Natalie-Leaist/I2C-Level-Converter/I2C-level-Converter/BR-100060-002_RevB_PCBA_Outputs/I2C-level-Converter Odoo BOM.xlsx

External ID | Reference | Product | Quantity | BoM Type | BoM Lines/Component | BoM Lines/Quantity
mrp_bom_BR-100060-002 | BOM_PCB | BR-100060-002 | 1 | Manufacture this product | component.bre_BRE_000034 | 2
mrp_bom_BR-100060-002 | BOM_PCB | BR-100060-002 | 1 | Manufacture this product | component.bre_BRE_000038 | 2
mrp_bom_BR-100060-002 | BOM_PCB | BR-100060-002 | 1 | Manufacture this product | component.bre_BRE_001368 | 1
mrp_bom_BR-100060-002 | BOM_PCB | BR-100060-002 | 1 | Manufacture this product | component.bre_BRE_000096 | 1
mrp_bom_BR-100060-002 | BOM_PCB | BR-100060-002 | 1 | Manufacture this product | component.bre_BRE_001188 | 4
mrp_bom_BR-100060-002 | BOM_PCB | BR-100060-002 | 1 | Manufacture this product | component.bre_BRE_001367 | 1
mrp_bom_BR-100060-002 | BOM_PCB | BR-100060-002 | 1 | Manufacture this product | component.bre_BRE_001365 | 1
mrp_bom_BR-100060-002 | BOM_PCB | BR-100060-002 | 1 | Manufacture this product | component.bre_BRE_000203 | 1
