Natalie-Leaist/I2C-Level-Converter/I2C-level-Converter/I2C-level-Converter Stock Info.xlsx

# Boards: | 5 | <---- EDIT NUMBER OF BOARDS HERE
Project: | I2C-level-Converter
BR Number: | BR-100060-002 RevB
Date: | 2026-01-23T16:35:55-0800
Legend
In stock @ JLC
Low Stock @ JLC
Not Enough Stock @ JLC
Does not exist @ JLC
BRE Number | Reference | Description | Quantity/Board | Total Quantity | MPN | JLCPCB Part # | JLC Stock | Global + Consigned Stock | Alt JLC Parts | DigiKey Parts | Mouser Parts | Other Vendor Parts | Unit Cost | Cost Per Board
BRE-000034 | C1, C4 | 100nF 100V X7R 10% Ceramic Capacitor 0603 AEC-Q200 | 2 | 10 | GCJ188R72A104KA01D | C161117 | 1555 | 0 |  | 490-13420-1-ND | 81-GCJ188R72A104KA1D |  | $0.02 | $0.03
BRE-000038 | C2, C3 | 1uF 50V X7R 10% Ceramic Capacitor 0603 | 2 | 10 | CL10B105KB8NQNC | C5199872 | 3800 | 0 |  |  | 187-CL10B105KB8NQNC |  | $0.0043 | $0.01
BRE-001368 | J3 | Connector Header 4 position 1.25mm Pitch 1A Surface Mount,Vertical | 1 | 5 | DF13C-4P-1.25V(21) | C116890 | 0 | 0 |  |  |  |  | $0.00 | $0.00
BRE-000096 | J4 | JST-GH Connector 4-pos, P=1.25mm, 1A 50V 30mΩ, 26-30awg, Vertical | 1 | 5 | BM04B-GHS-TBT | C161692 | 0 | 659 |  | 455-BM04B-GHS-TBTCT-ND |  |  | $0.10 | $0.10
BRE-001188 | R1, R2, R4, R5 | 1k 1% 100ppm 100mW Thick Film Resistor 0603 | 4 | 20 | 0603WAF1001T5E | C21190 | 1000 | 0 |  |  |  |  | $0.0006 | $0.0024
BRE-001367 | R3 | R_0603_200k | 1 | 5 | 0603WAF2003T5E | C25811 | 0 | 0 |  |  |  |  | $0.00 | $0.00
BRE-001365 | U1 | PCA9306D,118, -40℃~+105℃ 1 1.8V~5.5V 1V~3.6V 2 2Mbps Auto Direction Detection Bidirectional Open Drain SO-8 Translators, Level Shifters ROHS | 1 | 5 | PCA9306D,118 | C2677369 | 0 | 0 |  |  |  |  | $0.00 | $0.00
BRE-000203 | U2 | Linear Regulator, 2.5 - 5.5V Input, 150mA, 3.3V Output, SC-70-5 (1.8x1.8) | 1 | 5 | MIC5365-3.3YC5-TR | C73103 | 395 | 0 |  | 576-3193-2-ND | 998-MIC5365-3.3YC5TR |  | $0.14 | $0.14
 |  |  |  |  |  |  |  |  |  |  |  |  | Total BOM Cost: | $0.29
DNP Components
BRE Number | Reference | Description | Quantity/Board | Total Quantity | MPN | JLCPCB Part # | JLC Stock | Global + Consigned Stock | Alt JLC Parts | DigiKey Parts | Mouser Parts | Other Vendor Parts | Unit Cost | Cost Per Board
BRE-001042 | J1, J2 | Header Pin Connector 01x04 2.54mm (0.100") Vertical PTH | 2 | 10 | PZ254V-11-04P | C2691448 | 0 | 0 | C6332197, C5116483 |  |  |  | $0.00 | $0.00
