Natalie-Leaist/I2C-Level-Converter/I2C-level-Converter/BR-100060-002_RevB_PCBA_Outputs/I2C-level-Converter.step

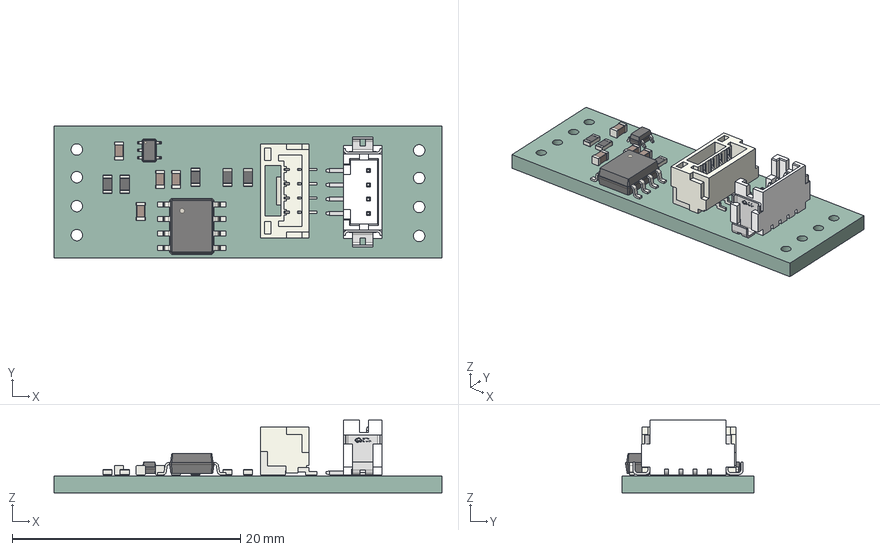
[picture p1: CAD file, 2026-01-24]
I2C-level-Converter/BR-100060-002_RevB_PCBA_Outputs/I2C-level-Converter.step
34.0 x 11.6 x 6.39 mm
R_0603_1608Metric x 5
CONN-SMD_DF13C-4P-1.25V-21
SOT-353_SC-70-5
C_0603_1608Metric x 4
SO-8_3.9x4.9mm_P1.27mm
JST_GH_BM04B-GHS-TBT_1x04-1MP_P1.25mm_Vertical
I2C-level-Converter_PCB
