Natalie-Leaist/I2C-Level-Converter/I2C-level-Converter/BR-100060-002_RevB_PCBA_Outputs/PCB_PDF/I2C-level-Converter.pdf

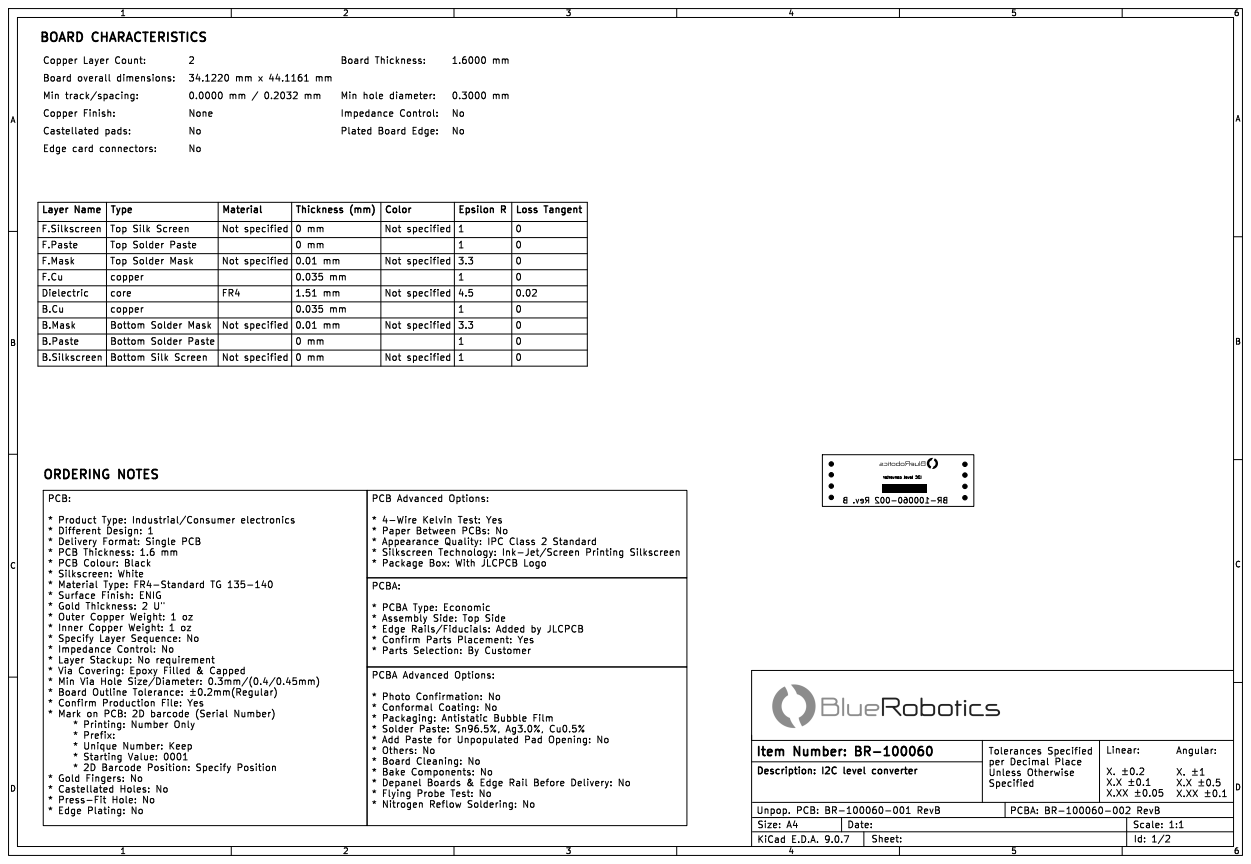
[picture p2: page 1]

Copper Layer Count: Top Solder Paste F.Silkscreen F.Cu

Type | | | Not specified | 3.3 Edge card connectors:

Top Silk Screen | Not specified | | Not specified | 3.3 Material F.Mask R 1 | 0 Epsilon

Dielectric | Bottom Solder Mask | | | | | | (mm) Bottom Silk Screen 0 mm 0.01 mm | Not specified Thickness | | 0

0.035 mm | | | 0 Not specified Not specified 0

copper B.Silkscreen core Bottom Solder Paste | | | 0.035 mm | | 4.5 B.Mask

1 B.Paste

* Delivery Format: Single PCB
* PCB Thickness: 1.6 mm
* PCB Colour: Black
* Surface Finish: ENIG
* Gold Thickness: 2 U" * Outer Copper Weight: 1 oz

* Paper Between PCBs: No
* Appearance Quality: IPC Class 2 Standard

* Inner Copper Weight: 1 oz
* Specify Layer Sequence: No
* Impedance Control: No
* Layer Stackup: No requirement * Via Covering: Epoxy Filled & Capped

* Assembly Side: Top Side

* Solder Paste: Sn96.5%, Ag3.0%, Cu0.5%
* Others: No
* Board Cleaning: No
* Depanel Boards & Edge Rail Before Delivery: No
* Flying Probe Test: No

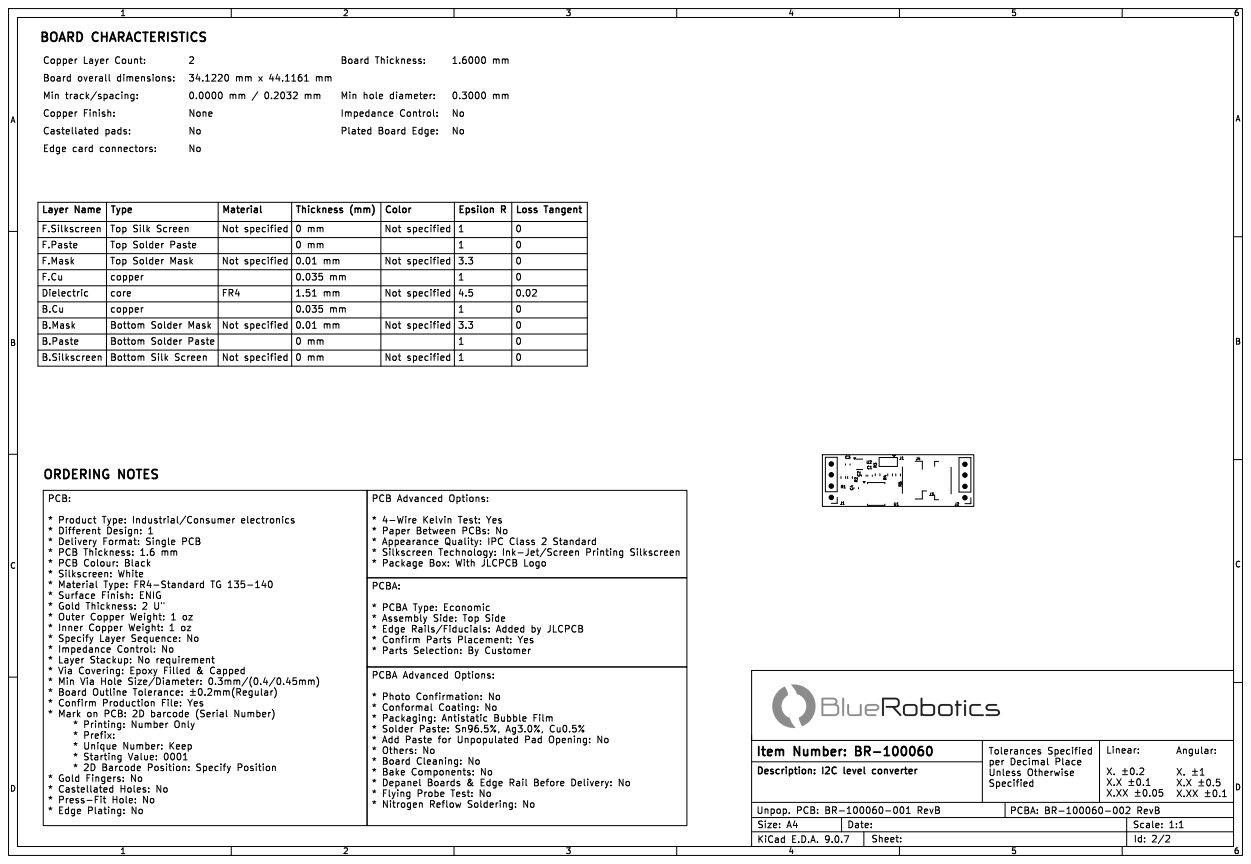
[picture p3: page 2]

Copper Layer Count: Top Solder Paste F.Silkscreen F.Cu

Type | | | Not specified | 3.3 Edge card connectors:

Top Silk Screen | Not specified | | Not specified | 3.3 Material F.Mask R 1 | 0 Epsilon

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

0.035 mm | | | 0 Not specified Not specified 0

copper B.Silkscreen core Bottom Solder Paste | | | 0.035 mm | | 4.5 B.Mask

1 B.Paste

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

* Paper Between PCBs: No
* Appearance Quality: IPC Class 2 Standard

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

* Assembly Side: Top Side

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
