Natalie-Leaist/I2C-Level-Converter/I2C-level-Converter/BR-100060-002_RevB_PCBA_Outputs/Schematic_PDF/I2C-level-Converter.pdf

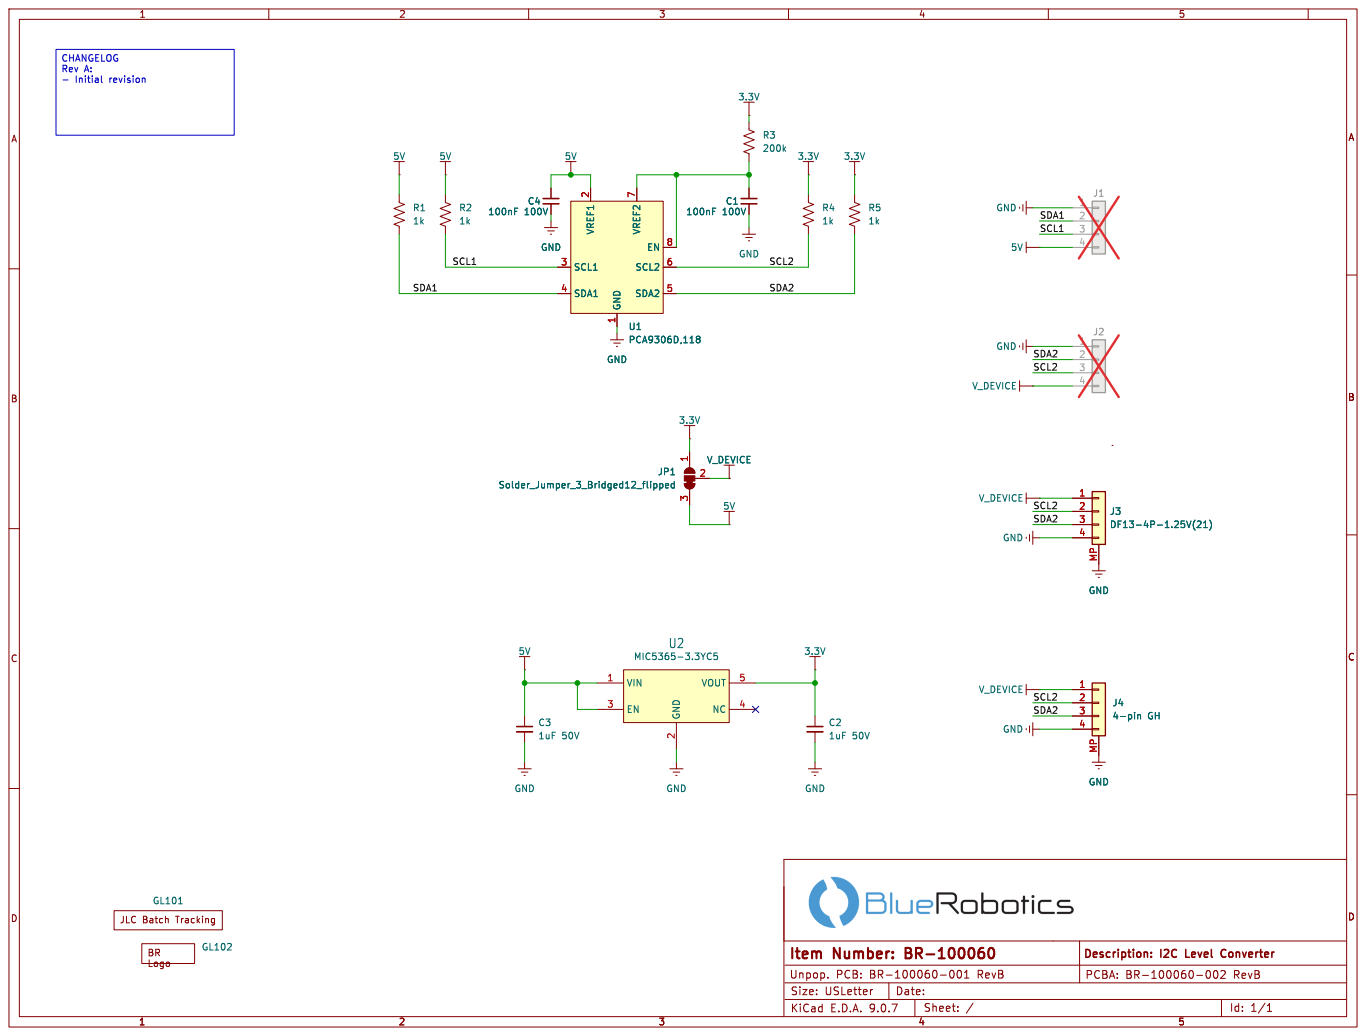
[picture p4: page 1]
