Natalie-Leaist/I2C-Level-Converter/I2C-level-Converter/I2C-level-Converter.kicad_pcb

## KiCad design I2C-level-Converter/I2C-level-Converter.kicad_pcb (2026-01-24)

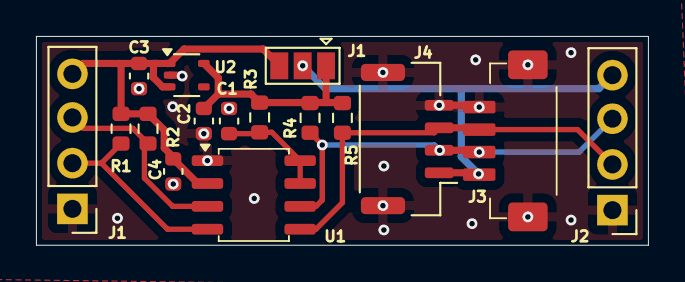
[picture p5: board I2C-level-Converter.kicad_pcb from above]

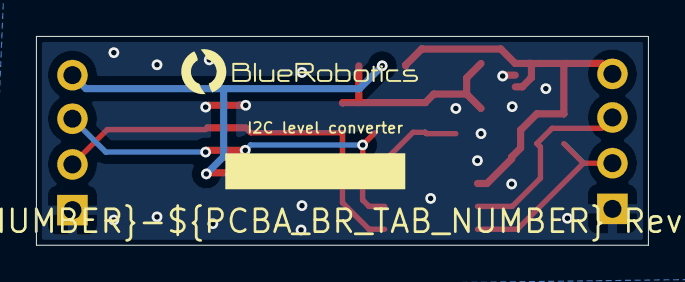
[picture p6: board I2C-level-Converter.kicad_pcb from below]

Board: 2 copper layers, 34.0 x 11.6 mm, 18 parts (2 on the bottom side), 9 nets.

Parts:
C1, C4: 100nF 100V; C_0603_1608Metric-minimized
C2, C3: 1uF 50V; C_0603_1608Metric-minimized
GL1: JLC_Number
GL2: BR_Logo
J1: Pin_Header_1x4_2.54mm_Vertical
J1#2: Solder_Jumper_3_Bridged12_flipped; SolderJumper-3_P1.3mm_Open_Pad1.0x1.5mm_paste
J2: 4-pin header; Pin_Header_1x4_2.54mm_Vertical
J3: DF13-4P-1.25V(21); HRS_DF13C_4P_1.25V(21)
J4: 4-pin GH; BM04B-GHS-TBT
R1, R2, R4, R5: 1k; R_0603_1608Metric
R3: 200k; R_0603_1608Metric
U1: PCA9306D,118; SO-8_3.9x4.9mm_P1.27mm_correct
U2: MIC5365-3.3YC5; SOT-353_SC-70-5

Connections:
3.3V: C2.1, J1#2.1 (B), R3.1, R4.1, R5.1, U2.5 (VOUT)
5V: C3.1, C4.1, J1.4, J1#2.3 (A), R1.1, R2.1, U1.2 (VREF1), U2.1 (VIN), U2.3 (EN)
/SCL1: J1.3, R2.2, U1.3 (SCL1)
/SCL2: J2.3, J3.2 (Pin_A2), J4.2, R4.2, U1.6 (SCL2)
/SDA1: J1.2, R1.2, U1.4 (SDA1)
/SDA2: J2.2, J3.3 (Pin_A3), J4.3, R5.2, U1.5 (SDA2)
GND: C1.2, C2.2, C3.2, C4.2, J1.1, J2.1, J3.4 (Pin_A4), J3.MP, J4.4, J4.MP, U1.1 (GND), U2.2 (GND)
unnamed: C1.1, R3.2, U1.7 (VREF2), U1.8 (EN)
V_DEVICE: J1#2.2 (C), J2.4, J3.1 (Pin_A1), J4.1
