Natalie-Leaist/I2C-Level-Converter/(commit log)

2026-01-08 almost finish board
    [I2C-Level-Converter.kicad_sch, br-project-template.kicad_pro.kicad_pcb, br-project-template.kicad_pro.kicad_sch]
2026-01-10 finish pcb (mostly)
    [br-project-template.kicad_pro.kicad_pcb]
